AleksandrYanovskiy/led-strip-szbox-s1/README.md

# led-strip-szbox-s1
***English***
| [Русский](README.ru.md)
___
Solving the problem with the non-working LED strip on the mini-PC SZBOX S1 (ACEMAGIC S1)
___
## 1. Background
When choosing a server for PROXMOX, the mini-PC **SZBOX S1 Intel Alder Lake N97** (copy of **ACEMAGIC S1**) on Aliexpress was selected.

<div>
  <p align="center">
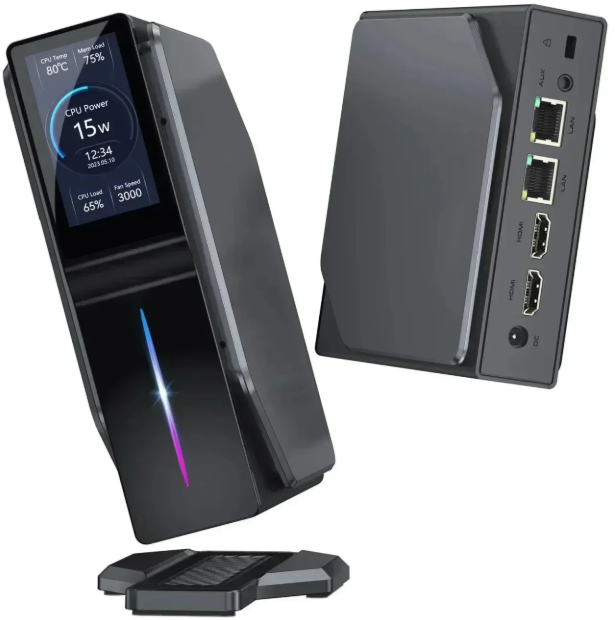
[picture p1: images/szbox-s1.png]
mini-PC SZBOX S1
    
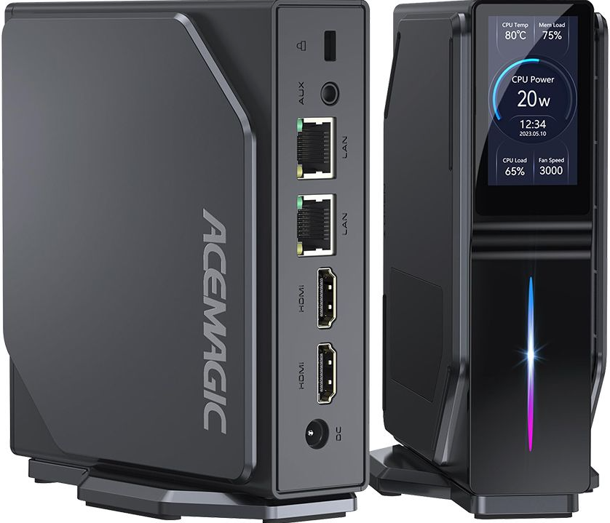
[picture p2: images/acemagic-s1.png]
min PC ACEMAGIC S1
    
    <br>
    <em>SZBOX S1 and ACEMAGIC S1</em>
  </p>
</div>
<br>

The PC easily supports a memory capacity of up to 32GB, despite the fact that the description indicated only a maximum of 16GB.\
Also, the presence of an information display made this PC simply indispensable for a home server.

Thanks to the project [AceMagic-S1-LED-TFT-Linux](https://github.com/tjaworski/AceMagic-S1-LED-TFT-Linux) (many thanks to the author!) the display and LED bottom backlight worked in Linux without any problems.\
But, unfortunately, after a few months a malfunction appeared - the LED backlight stopped working.

___
## 2. Can it be repaired?
An idea arose to fix the broken LED-backlight.\
The housing was disassembled and the LED-module was removed to be checked.\
The module contains 6 addressable RGB LEDs, and passive elements in the form of a resistor and several capacitors.\
In fact, the module does not contain any control elements, it is simply a set of addressable RGB LEDs.
<div>
  <p>
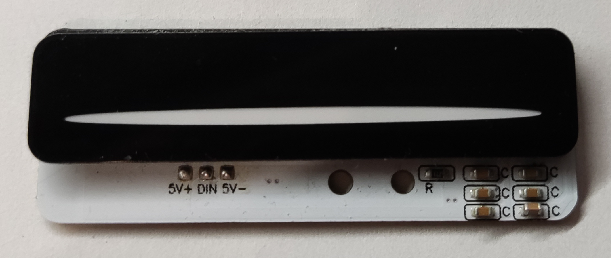
[picture p3: images/led-strip-1.png]
LED module
    
    <br>
    <em>LED module</em>
  </p>
  <p>
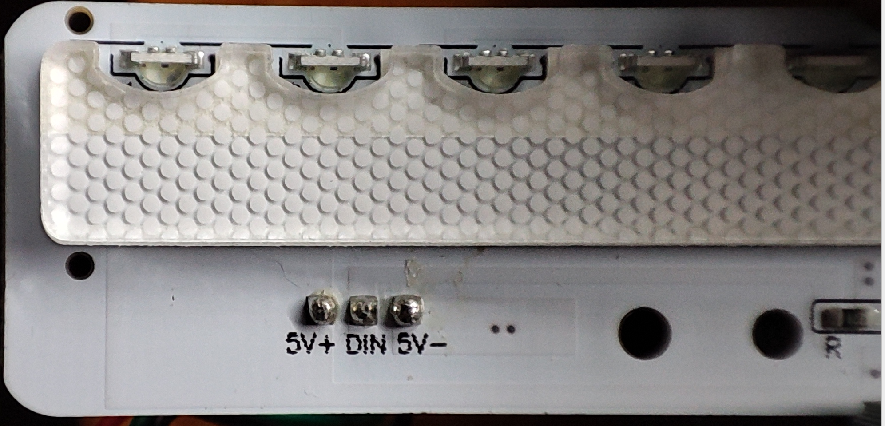
[picture p4: images/led-strip-2.png]
LED module without top cover
    
    <br>
    <em>LED module without top cover</em>
  </p>
  <p>
    LED module on the back side
    <br>
    <em>LED module and TFT screen on the back side</em>
  </p>
</div>
<br>

It turned out that it is connected to the main board via a connector that can be disconnected and the module can be removed completely.\
The module was connected to another mini-PC - and the backlight module turned out to be working.

There was an attempt to analyze the LED module control circuit.\
The module is powered by +5V and has one control pin.

It turned out that the control pin is connected to a chip that is not marked
(except for the letter B, where the key is on the body of the 1st pin).\
The chip is located on the board near the power button, under the radiator and has the number **U31**:
<div>
  <p>
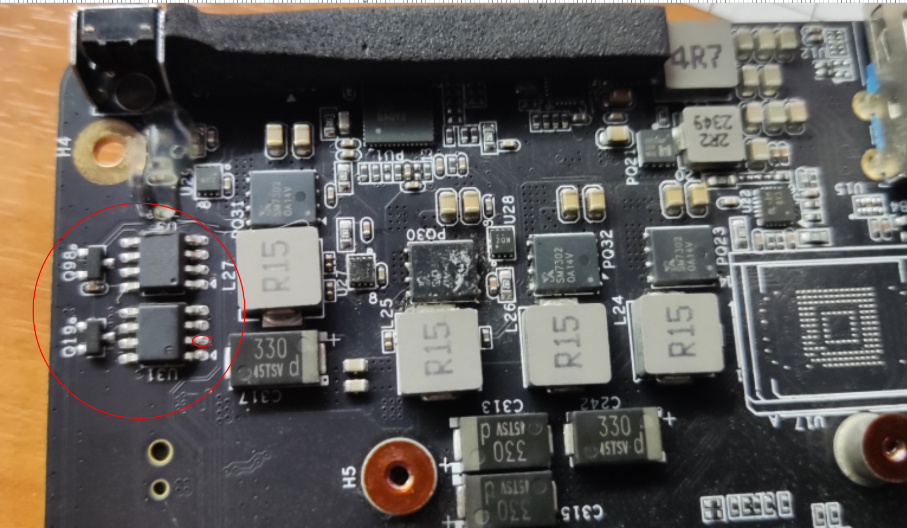
[picture p5: images/board-1.png]
Unidentified chip and UART chip
    
    <br>
    <em>On the left is the LED module control chip and the UART chip</em>
  </p>
  <p>
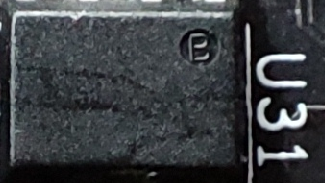
[picture p6: images/u31.png]
Unknown chip U31
    
    <br>
    <em>Unknown chip U31</em>
  </p>
</div>
<br>

The chip pin **U31-2** is connected to the module pin **LED-DIN**.\
Nearby is the **U3** - **CH340N** - **USB to UART TTL Converter** chip.

The connection diagram with the signals on the working chip:
<div>
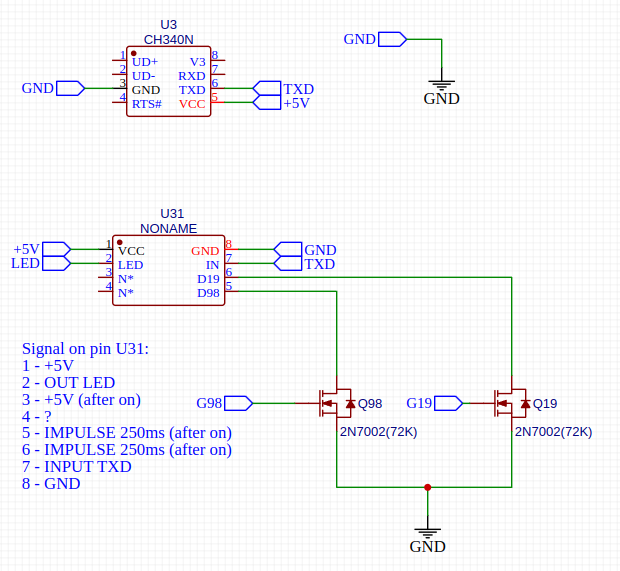
[picture p7: images/scheme-u31.png]
scheme-u31
  
</div>

On the faulty chip **U31** there are no signals at the following pins:\
**2, 3, 5, 6**.

It turned out that this chip is either a microcontroller or a special chip that performs the following functions:
* when the power is turned on - it generates a signal at pin 2, and the LED backlight starts working according to the primary algorithm, even if there are no disks or memory in the PC.
* the chip can be specified in the LED operating mode by sending a command via UART of a certain type, which it receives on pin 7, connected to the **U3-6(TXD)** chip.

The assignment of MOSFET **Q19** and **Q98** could not be determined.\
One thing is clear - transistors are not needed for RGB LEDs - they do not consume that much current to be switched through these MOSFET switches.

At all terminals with a multimeter in diode testing mode, the same voltage drop is observed, as at a working **U3**.\
The 3rd conclusion raises the question: is it an output or an input? It was not possible to find where it is connected on the board.
\It is possible that the presence of +5V on it turns on the chip.

Unfortunately, the search for chips using the specified connections was unsuccessful.

___
## 3. What can be done?
Since it was not possible to find a circuit diagram on a mini-PC, the question arose - is it possible to restore the operation of the LED module in any other way?\
There is a simple Arduino compatible module with **Attiny85** called **Digispark**.\
With USB-micro connector:
<div>
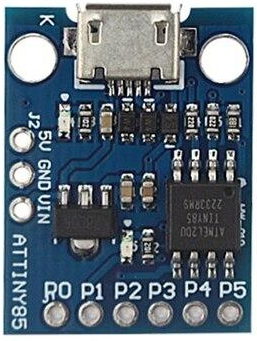
[picture p8: images/digispark-micro.png]
Digispark with mico-usb connector
  
</div>

These modules come in several types:
<div>
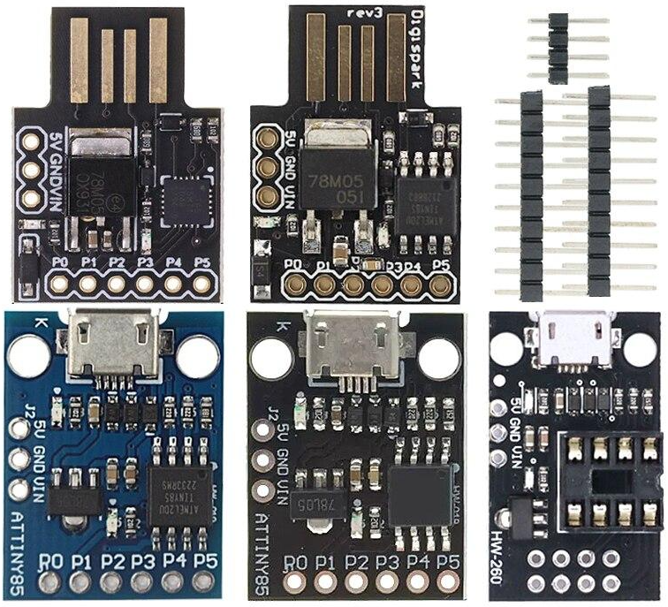
[picture p9: images/digispark-var.png]
Digispark module options
  
</div>
<br>

The LED module was connected to **Digispark**, and, using **Adafruit's NeoPixel** library, the module worked!

<div>
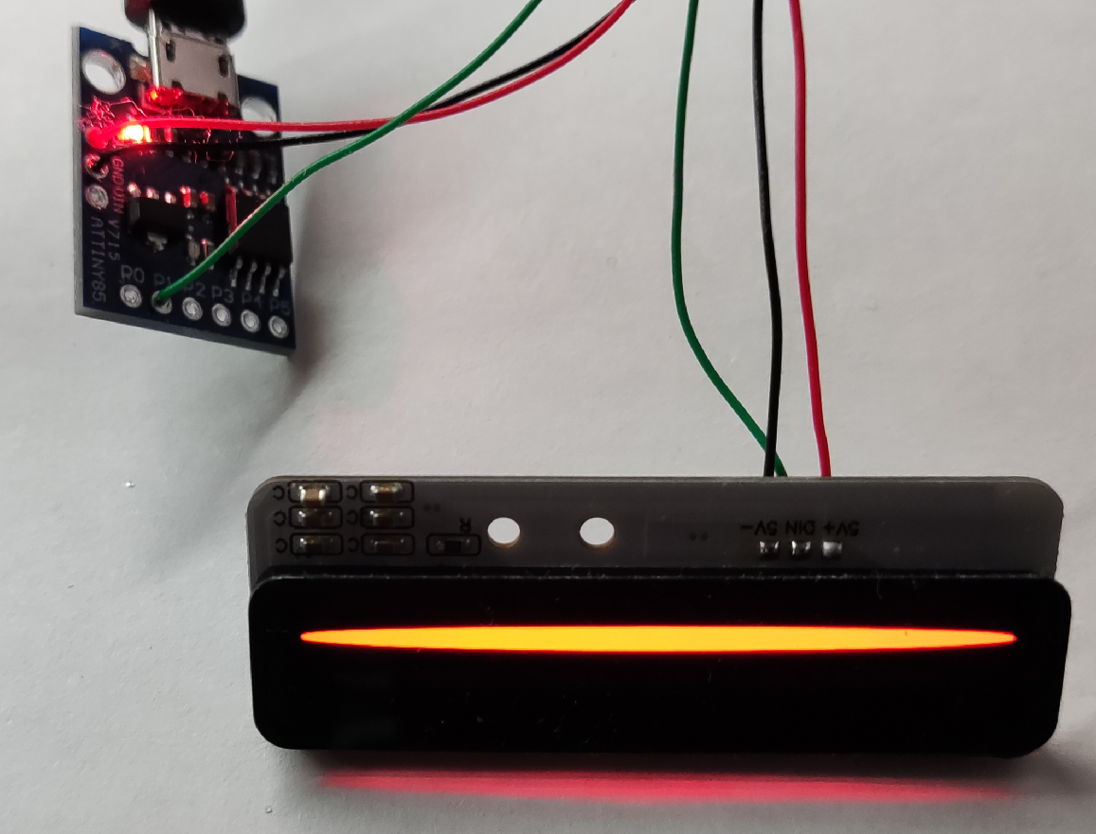
[picture p10: images/led-work-1.png]
The LED module lights up yellow-orange
  
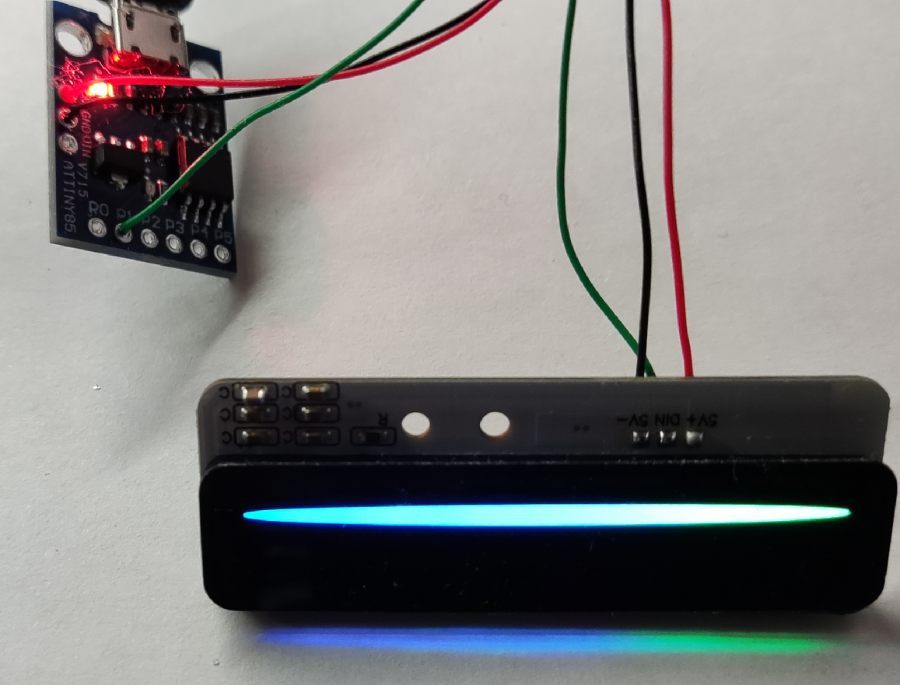
[picture p11: images/led-work-2.png]
The LED module lights up blue-white
  
</dev>

___
## 4. Scheme

> :warning: **DISCLAIMER**\
All information and program files provided below are for informational purposes only and are provided without any warranties. Modifications or tampering with your device may void your warranty, permanent equipment damage, or personal injury. The author is not responsible for any damage to your hardware, programs, property or health. You act at your own risk. All proposed improvements are provided for review purposes and are not required to be repeated. Always follow safety precautions when working with electronics and ensure that your operations comply with local laws and safety standards.
___

The **Digispark** board has the following pins:

<div>
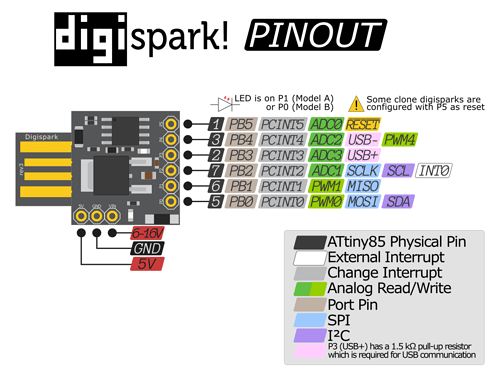
[picture p12: images/digispark-board-pinout-2.png]
Description of Digispark pins
  
</div>
<br>

Power from the PC board is connected via the standard connector **JST SH 3pin**.\
+5V is connected to the 5V pin via a diode (red wire in the diagram below).\
The common pin is connected to the GND pin (black wire in the diagram below).\
The center pin is not connected.

In the Arduino sketch described [further](#5-arduino-sketch), the code refers to the names of the pins - `PB0`, `PB1`, etc.\
In fact, only pins `PB0 PB1 PB2` can be used in **Digispark**.\
The `PB1` pin, in this case, is connected to the LED on the **Digispark** board, so it was decided to use it as a pin to control the LED module - the activity of the commands being sent is visible. The `PB2` pin is used to read data from the UART, the `PB0` pin can be used to send debugging data to the UART.

### Variant 1
The simplest improvement variant.
<details>
<summary>Diagram and description</summary>
<br>
  No intervention is required in the PC electronics; there is no need to disassemble the mini-PC - just remove the side cover with magnets.
<br>
<br>

> :exclamation:
For the LED module to work, it does not need to be connected to the UART. By default, the program code is configured to cycle through all RGB effects one by one and does not need any additional commands sent from the UART to work. Any mode can be selected in the sketch and will be repeated endlessly. Therefore, the connection to pins `PB0` and `PB2` can be omitted and soldering on the mini-PC board can be avoided.

  <div>
    <p align="center">
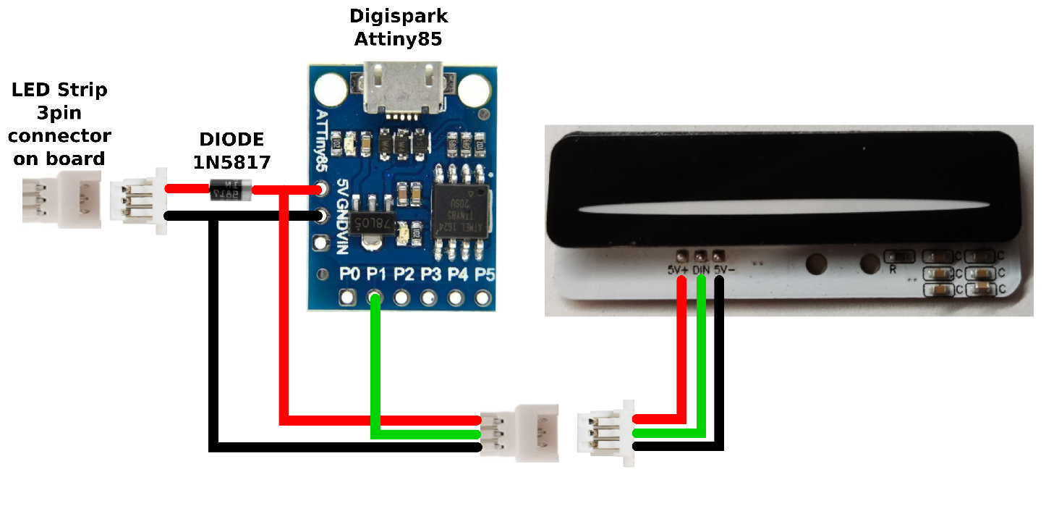
[picture p13: images/chematic-diagram-1.png]
Scheme 1st variant
      
      <br>
      <em>Connection diagram variant 1</em>
    </p>
  </div>
  <br>

  The **Digispark** module is connected between the LED module and the PC board. For this, connectors **JST-SH 3pin 1mm (male | female)** are used.
  <div>
    <p>
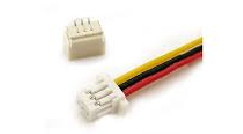
[picture p14: images/jst-sh-3p.png]
Jst-sh-3p connector
      
      <br>
      <em>JST SH 3PIN connector</em>
    </p>
    <p>
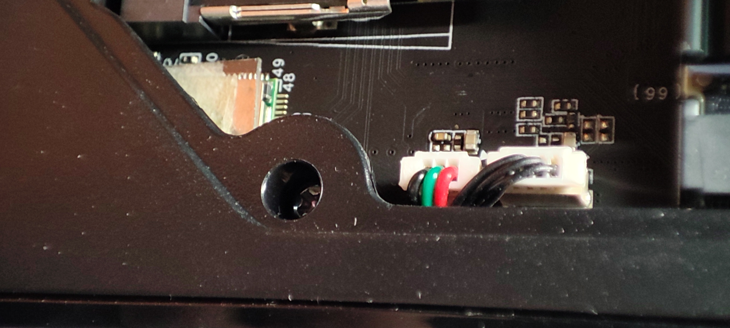
[picture p15: images/led-connector.png]
LED module connection connector
      
      <br>
      <em>LED module connection connector (left)</em>
    </p>
  </div>
  <br>

  In the three pin connector that comes from the **Digispark** and connects to the PC board, the middle pin needs to be removed. It is also necessary to add a Schottky diode, with a minimal voltage drop across it, to the power wire break if you plan to subsequently connect the **Digispark** module to a PC with Arduino for its firmware. This is a protection against voltage supply to a mini-PC through the **Digispark** module.

</details>

### Variant 2
This variant is more complicated.
<details>
  <summary>Diagram and description</summary>
  <br>
    It is necessary to disassemble the mini-PC, remove the heatsink, and solder to one contact of the UART chip.
  <br>
  <br>

> :exclamation: **Explanation on working with UART:**\
Connection to **UART** is necessary so that you can programmatically set the desired operating mode of the LED module.(See [AceMagic-S1-LED-TFT-Linux](https://github.com/tjaworski/AceMagic-S1-LED-TFT-Linux)). The `PB2` **Digispark** pin is used for this.

  <div>
  <p align="center">
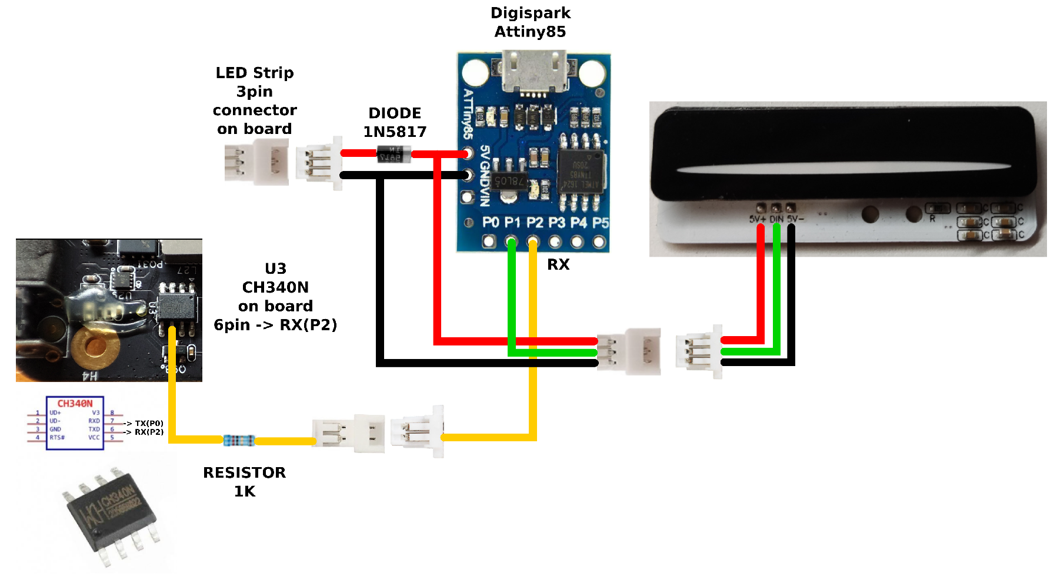
[picture p16: images/chematic-diagram-2.png]
Scheme 2nd variant
    
    <br>
    <em>Connection diagram variant 2</em>
  </p>
  </div>

  The connection to **U3** with a resistor looks like this:

  <div>
    <p>
      Wire with resistor
    </p>
    <p>
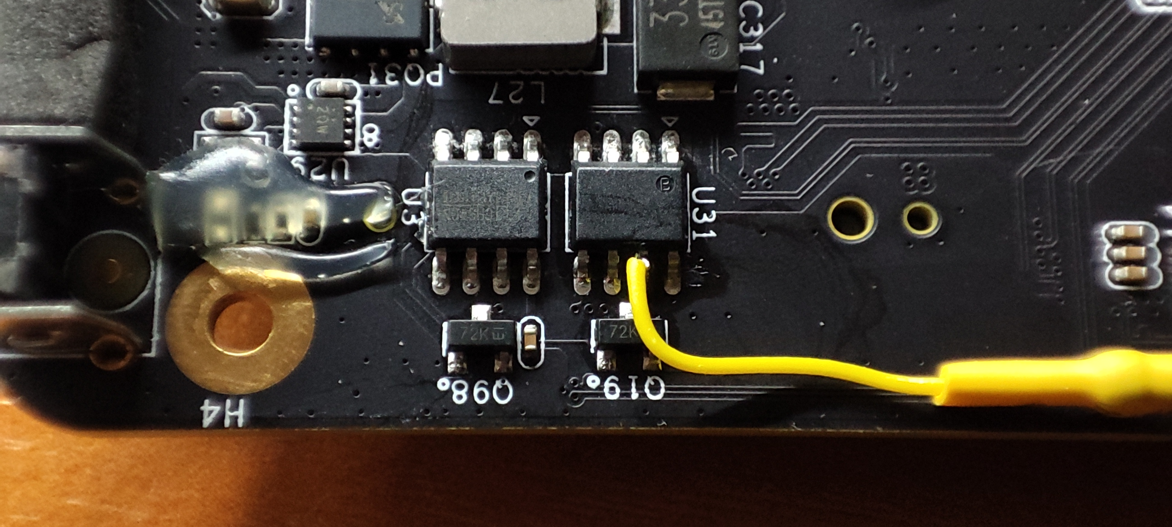
[picture p17: images/connect-2.png]
A wire with a resistor is connected to the chip
      
    </p>
    <p>
      General view of connection to the board
    </p>
  </div>
  <br>

  > :exclamation:
  > The image shows that the resistor wire is connected to **U31**, not **U3**. This was done simply for convenience, since the **U31-7** pin is physically connected to the **U3-6(TXD)** pin.

  Resistors on contacts `PB0` and `PB2` are needed to limit the current in case of a conflict between the signals on the **U3** chip and the **Digispark** module.

  The connection to **U3**, which is **CH340N - USB to UART TTL Converter** is made by soldering a wire to pin **6** of the chip on the mini-PC board.

  <div>
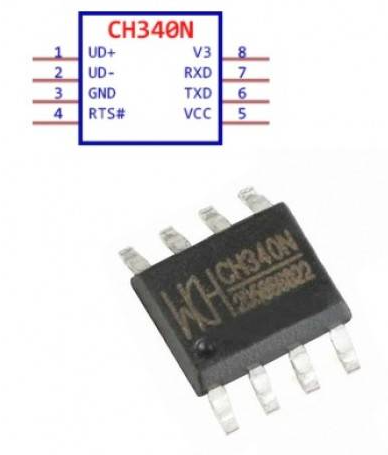
[picture p18: images/ch340n.png]
ch340n
    
  </div>
  <br>

  This chip is connected to the USB port on the board.\
  It is defined as a device **ID 1a86:7523 CH340 serial converter** and is used to set the LED panel modes programmatically.

  To avoid soldering on the mini-PC board while maintaining control over the effects, an external +5V USB-UART module can be used. It connects to any USB port, with a single wire running from the **TXD** pin to the **Digispark**.

  For example this or similar:
  <div>
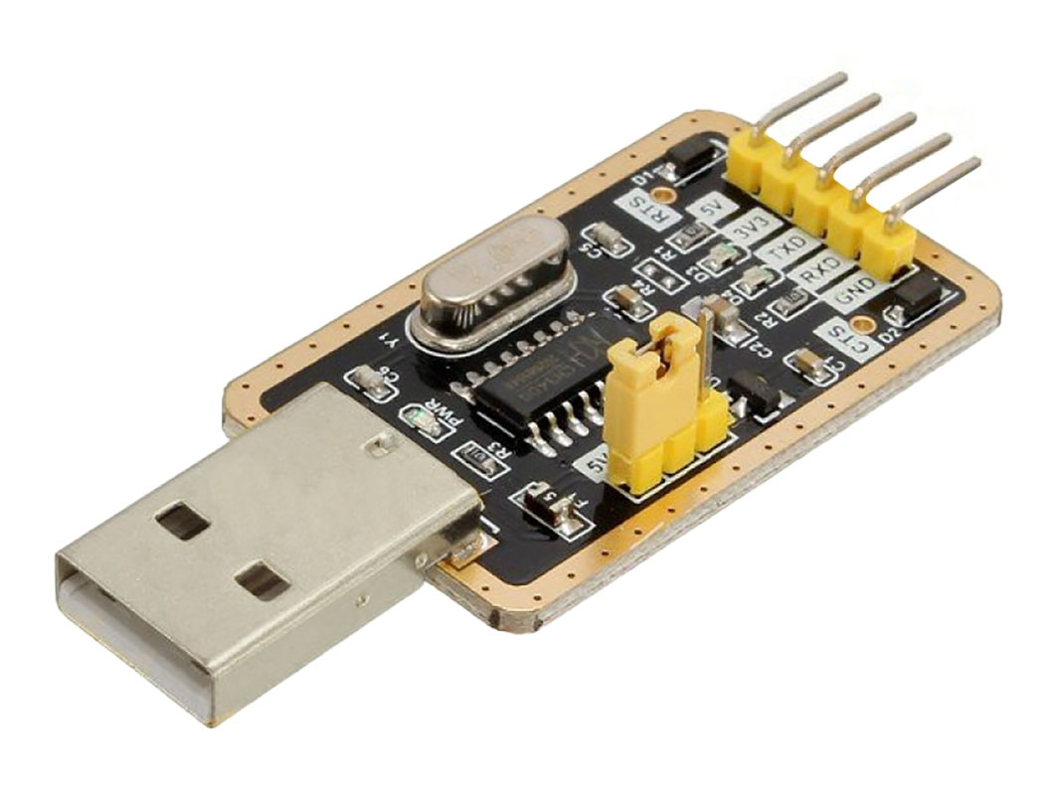
[picture p19: images/usb-uart.png]
usb-uart external module
    
    </div>
  <br>
</details>

### Variant 3
This variant is used to debug the **Digisdpark** module.
<details>
  <summary>Diagram and description</summary>
  <br>

  <div>
    <p align="center">
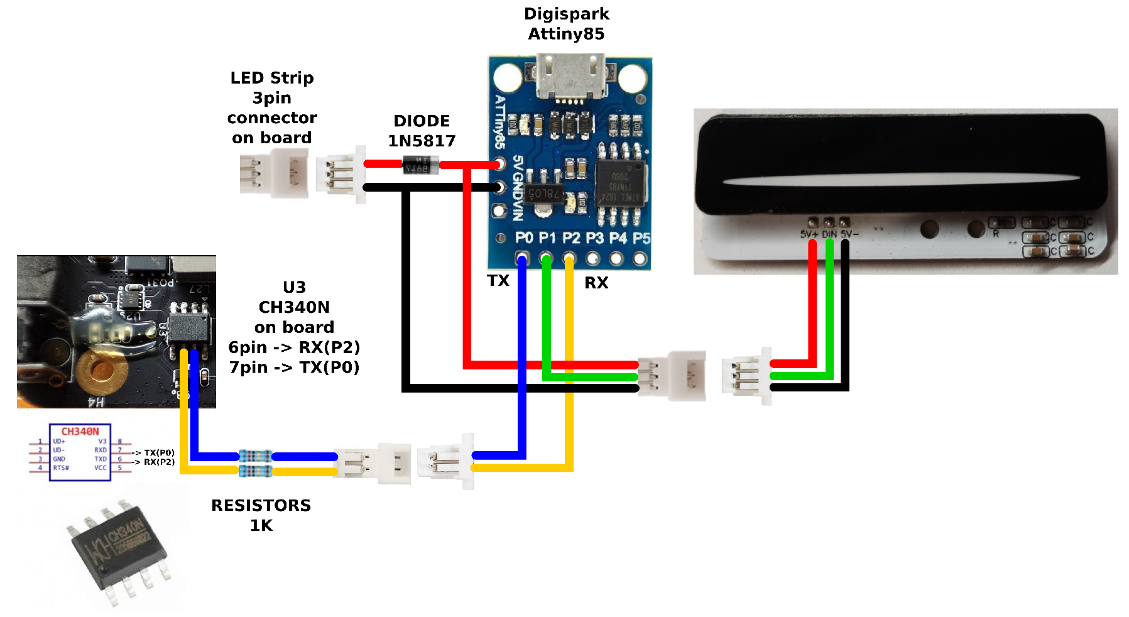
[picture p20: images/chematic-diagram-3.png]
Scheme 3rd variant
      
      <br>
      <em>Connection diagram variant 3</em>
    </p>
  </div>
  <br>

  To read debug information from the **Digispark** module, another wire with a resistor must be soldered to the UART chip.

  The `PB0` pin is used for debugging the sketch - outputting debugging information, and is not involved in setting the operating modes of the LED module.

  <br>

  <div>
    <p>
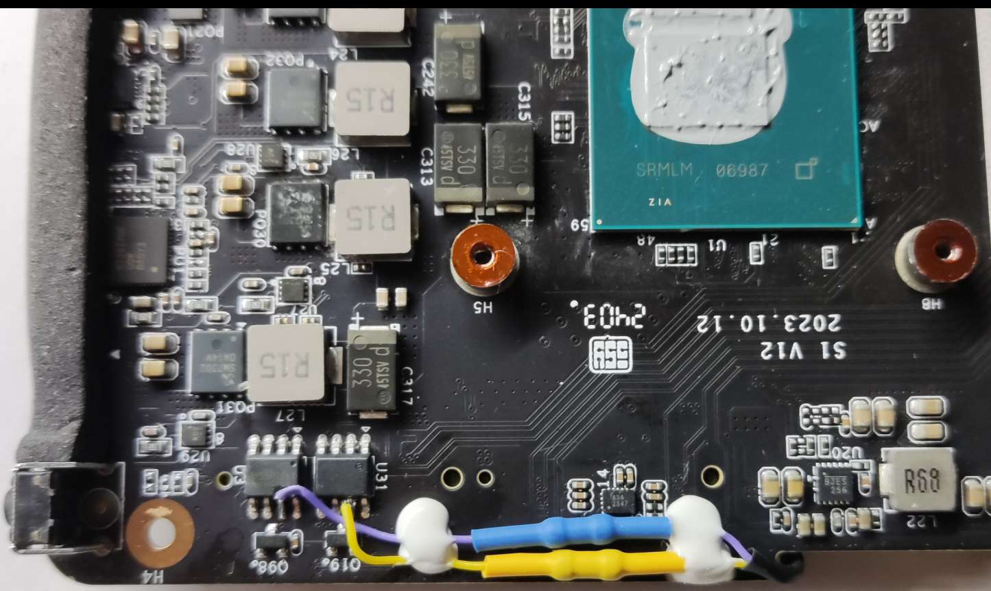
[picture p21: images/connect-4.png]
Wire with two resistors
      
      <br>
    <em>Connection to <b>U3</b> with two resistors</em>
    </p>
    <br>
    <p>
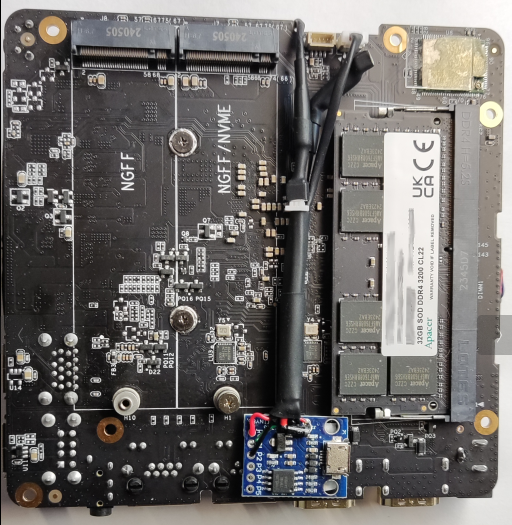
[picture p22: images/connect-5.png]
General view of the connected Digispark module
      
      <br>
    <em>General view of the connected module <b>Digispark</b></em>
    </p>
    <br>
    <p>
      Connected Digispark module in heat shrink
      <br>
      <em>Connected <b>Digispark</b> module in heatshrink</em>
    </p>
  </div>
  <br>
</details>

___
## 5. ARDUINO sketch
Arduino IDE is used for **Digispark** firmware.\
To configure **Arduino IDE** use [ATTinyCore](https://github.com/felias-fogg/ATTinyCore/blob/classic-debug-enabled/Installation.md).

**Digispark** parameter settings:
<div>
  <p>
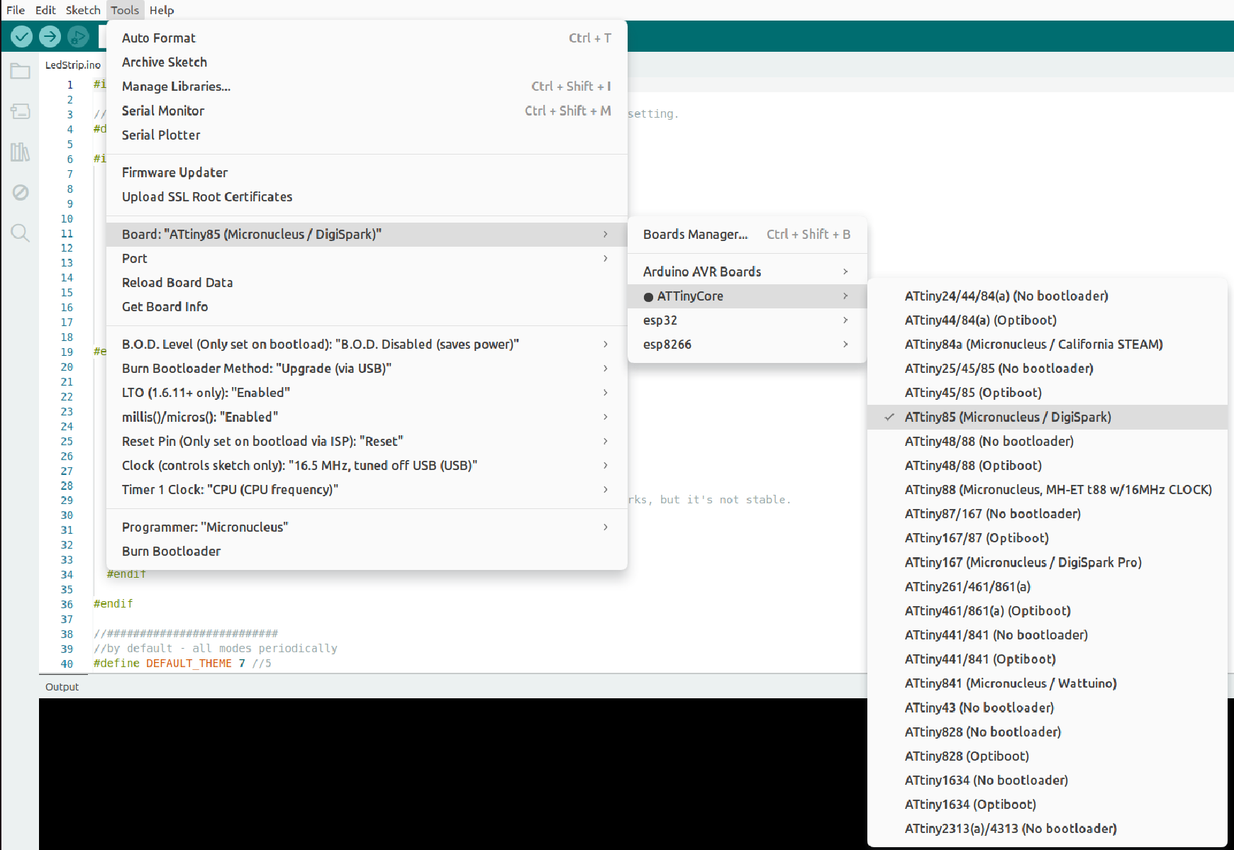
[picture p23: images/arduino-01.png]
Digispark board selection
    
    <br>
    <em>Digispark choice</em>
  </p>
  <br>
  <p>
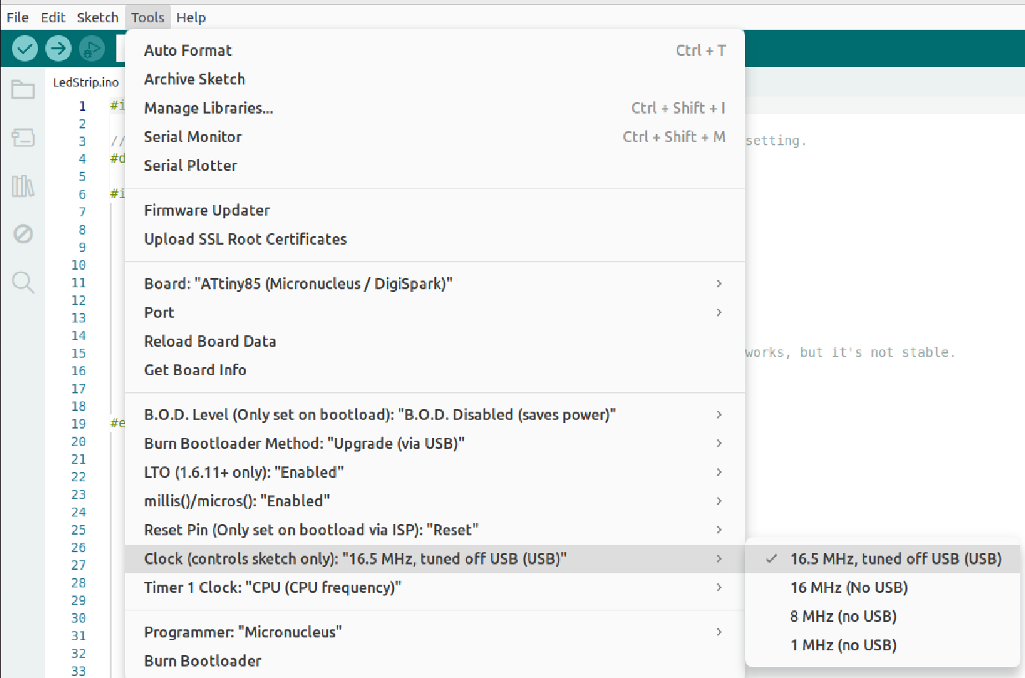
[picture p24: images/arduino-02.png]
Setting the CPU frequency
    
    <br>
    <em>Setting the CPU frequency</em>
  </p>
  <br>
  <p>
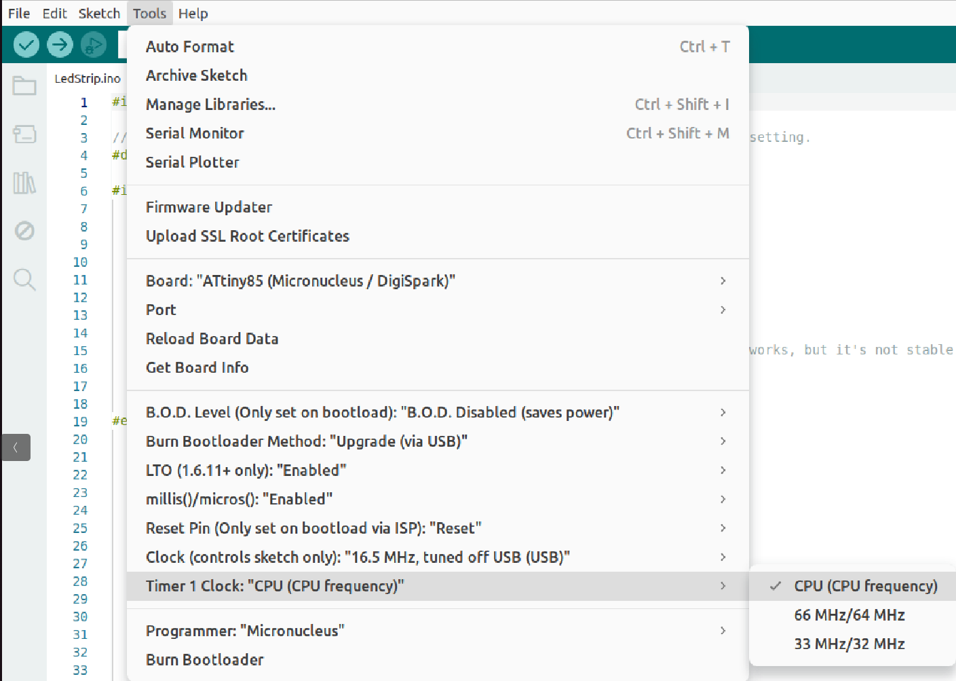
[picture p25: images/arduino-03.png]
Setting the timer
    
    <br>
    <em>Setting the timer</em>
  </p>
</div>
<br>

It is also necessary to add the **Adafruit Neopixel** library to the **Arduino IDE**:
<div>
  <p>
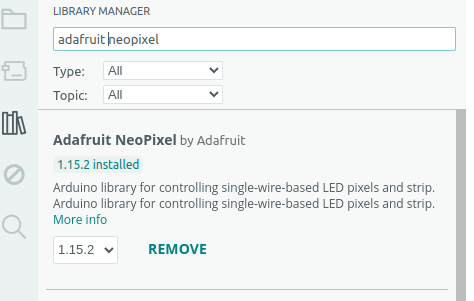
[picture p26: images/arduino-04.png]
Adafruit Neopixel Library
    
    <br>
    <em>Adafruit Neopixel Library</em>
  </p>
  <br>
</div>

The **Digispark** bootloader works on a different principle than, for example, the **Arduino UNO** board.\
When power is applied to the **Digispark** board, it immediately goes into bootloader mode and waits for the sketch to load for 60 seconds.\
This will be indicated in the **Arduino IDE** Output window before flashing the firmware.\
After loading, if there was one, or after a timeout of 60 seconds, the sketch itself starts working.\
Therefore, the start of the LED backlight after turning on the will occur with a slight delay.

The sketch contains a detailed description of its work.\
An attempt was made to implement the factory LED backlight modes, and several additional ones were added.

The speed of operation with **UART** was selected as `4800` as the most stable.The board can also work on `9600`, but it does not always recognize commands 100%.\
By the way, the original **UART** LED backlight at a speed of `9600` also does not work stably.\
The speed of operation with **UART** can be changed (_SERIAL_SPEED_).

The code also provides working with the **Arduino UNO** board and +5V strip **WS2812B** of 6 LEDs, for debugging and checking operating modes.\
In this case, the standard Serial object is used as **UART**.

As already mentioned [above](#variant-1) - the **Digispark** module can work with LED backlighting without **UART**. By default, when turned on, it will the cycle through all programmed effects.

___
## 6. Summary
As a result of the modernization, the LED backlight works again:
<div>
  <p>
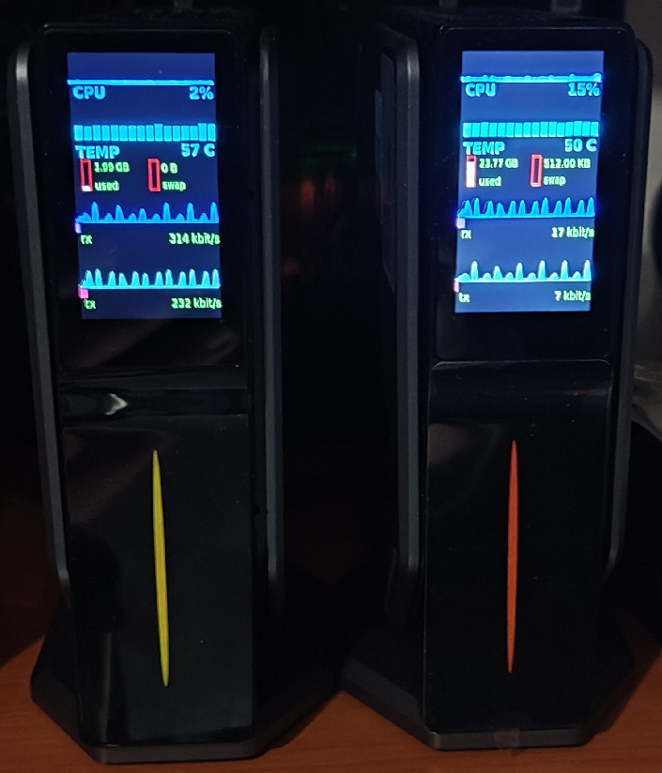
[picture p27: images/result.png]
LED backlight (left) works again
    
    <br>
    <em>LED backlight (left) works again</em>
  </p>
</div>
<br>

There may be another solution to the problem with the operation of the LED backlight.\
There is always the opportunity to return it “as it was” - by disabling the **Digispark** module.\
One of the advantages is that you can add any RGB effect yourself.
